basheeraltawil/agrobot-ros2-agricultural-robot-arm/agrobot_ws/src/aibomech_agrobot_description/meshes/link_2.STL

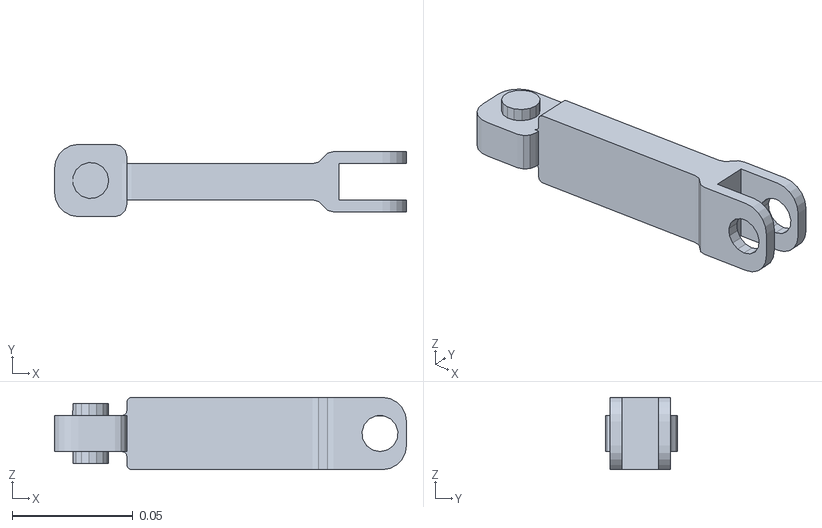
[picture p11: CAD file, 2026-09-24]
agrobot_ws/src/aibomech_agrobot_description/meshes/link_2.STL
0.146 x 0.03 x 0.03
