basheeraltawil/agrobot-ros2-agricultural-robot-arm/agrobot_ws/src/aibomech_agrobot_description/meshes/link_1.STL

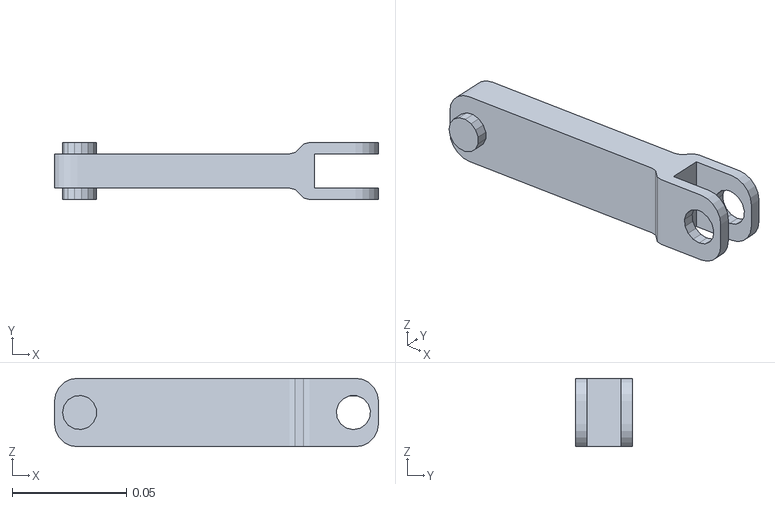
[picture p12: CAD file, 2026-09-24]
agrobot_ws/src/aibomech_agrobot_description/meshes/link_1.STL
0.142 x 0.025 x 0.03
