basheeraltawil/agrobot-ros2-agricultural-robot-arm/agrobot_ws/src/aibomech_agrobot_description/meshes/link_3.STL

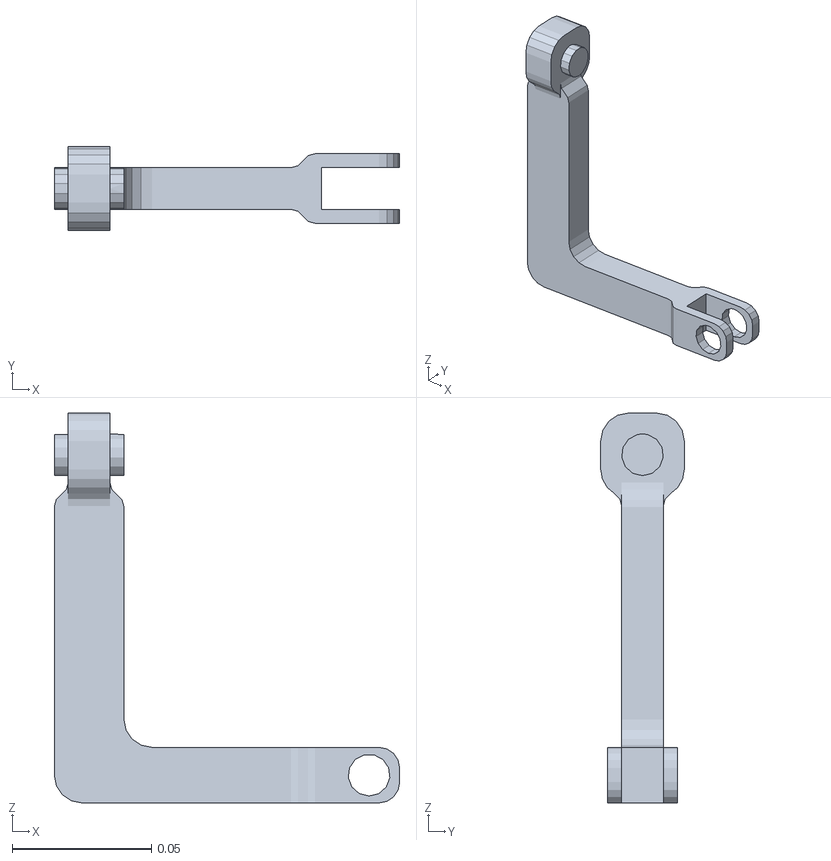
[picture p13: CAD file, 2026-09-24]
agrobot_ws/src/aibomech_agrobot_description/meshes/link_3.STL
0.124 x 0.03 x 0.14
