basheeraltawil/agrobot-ros2-agricultural-robot-arm/agrobot_ws/src/aibomech_agrobot_description/meshes/link_5.STL

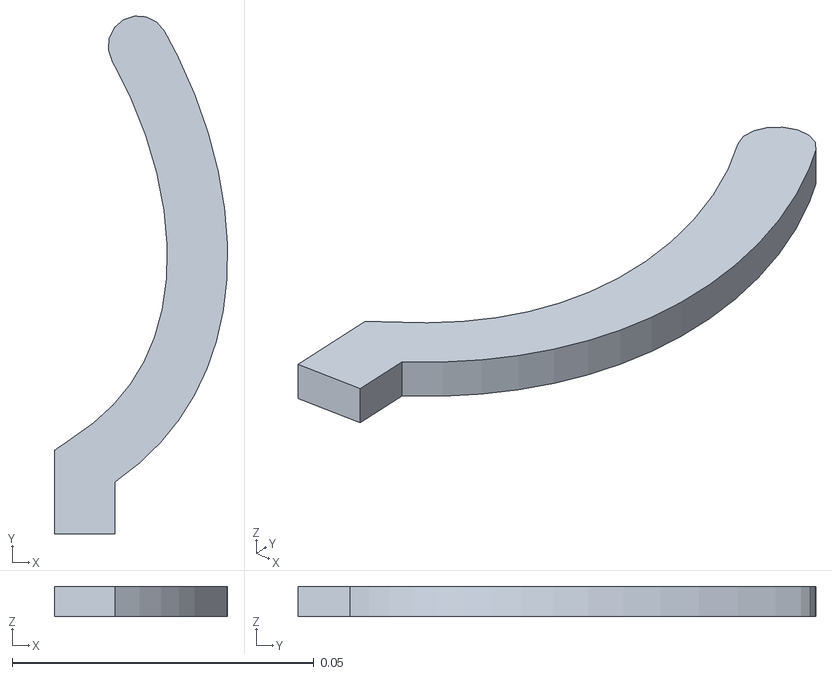
[picture p14: CAD file, 2026-09-24]
agrobot_ws/src/aibomech_agrobot_description/meshes/link_5.STL
0.0287 x 0.0858 x 0.005
