basheeraltawil/agrobot-ros2-agricultural-robot-arm/agrobot_ws/src/aibomech_agrobot_description/meshes/link_4.STL

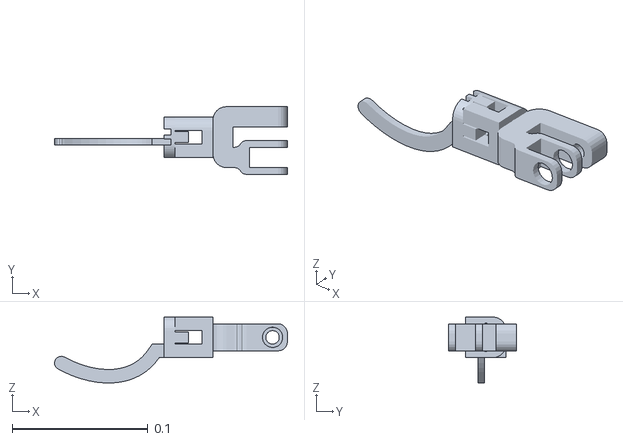
[picture p15: CAD file, 2026-09-24]
agrobot_ws/src/aibomech_agrobot_description/meshes/link_4.STL
0.172 x 0.05 x 0.0487
