basheeraltawil/agrobot-ros2-agricultural-robot-arm/agrobot_ws/src/aibomech_agrobot_description/meshes/base_link.STL

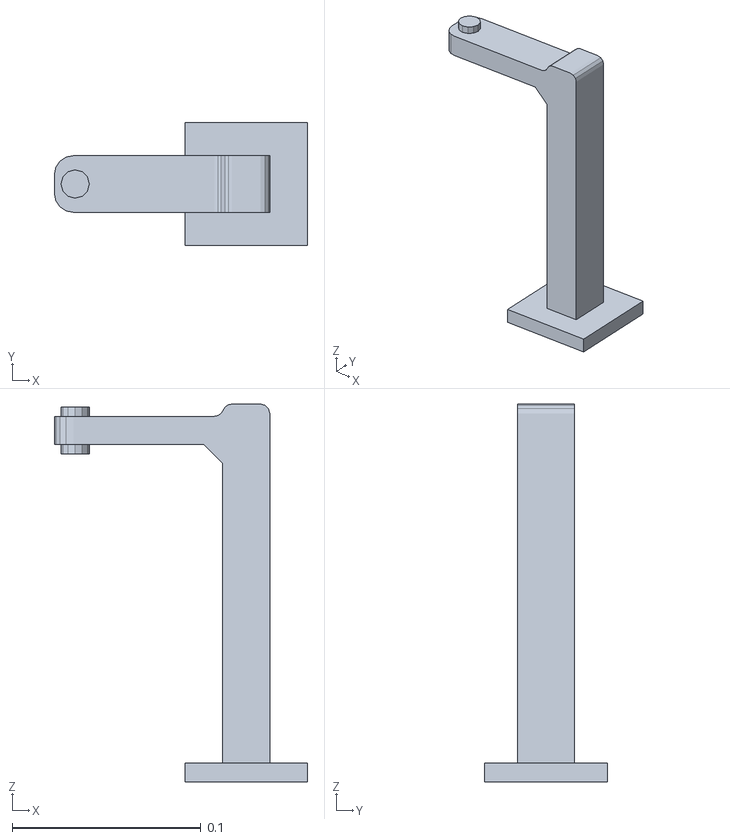
[picture p16: CAD file, 2026-09-24]
agrobot_ws/src/aibomech_agrobot_description/meshes/base_link.STL
0.134 x 0.065 x 0.2
