basheeraltawil/agrobot-ros2-agricultural-robot-arm/analysis/data/agrobot.urdf

<?xml version="1.0" ?>
<!-- =================================================================================== -->
<!-- |    This document was autogenerated by xacro from src/aibomech_agrobot_description/urdf/agrobot.urdf.xacro | -->
<!-- |    EDITING THIS FILE BY HAND IS NOT RECOMMENDED                                 | -->
<!-- =================================================================================== -->
<!--
  AIBOMECH AgroBot - complete robot cell.

  xacro agrobot.urdf.xacro hardware:=gz platform:=rail_trolley mount_height:=0.85
-->
<robot name="agrobot">
  <link name="world"/>
  <!-- Heating-pipe rail, fixed in the greenhouse -->
  <link name="rail">
    <inertial>
      <origin rpy="0 0 0" xyz="1.5 0 0.1"/>
      <mass value="50"/>
      <inertia ixx="0.6770833333333335" ixy="0" ixz="0" iyy="37.510416666666664" iyz="0" izz="38.166666666666664"/>
    </inertial>
    <visual name="pipe_left">
      <origin rpy="0 1.5707963267948966 0" xyz="1.4 0.2 0.1"/>
      <geometry>
        <cylinder length="3.6" radius="0.0255"/>
      </geometry>
      <material name="pipe_white">
        <color rgba="0.92 0.92 0.90 1"/>
      </material>
    </visual>
    <visual name="pipe_right">
      <origin rpy="0 1.5707963267948966 0" xyz="1.4 -0.2 0.1"/>
      <geometry>
        <cylinder length="3.6" radius="0.0255"/>
      </geometry>
      <material name="pipe_white">
        <color rgba="0.92 0.92 0.90 1"/>
      </material>
    </visual>
  </link>
  <joint name="rail_fixed_joint" type="fixed">
    <origin rpy="0 0 0" xyz="0 0 0"/>
    <parent link="world"/>
    <child link="rail"/>
  </joint>
  <link name="trolley">
    <inertial>
      <origin rpy="0 0 0" xyz="0 0 0.1955"/>
      <mass value="25.0"/>
      <inertia ixx="0.48770833333333335" ixy="0" ixz="0" iyy="0.5677083333333334" iyz="0" izz="0.9616666666666668"/>
    </inertial>
    <visual name="deck">
      <origin rpy="0 0 0" xyz="0 0 0.1955"/>
      <geometry>
        <box size="0.5 0.46 0.04"/>
      </geometry>
      <material name="graphite">
        <color rgba="0.20 0.21 0.23 1"/>
      </material>
    </visual>
    <collision name="deck">
      <origin rpy="0 0 0" xyz="0 0 0.1955"/>
      <geometry>
        <box size="0.5 0.46 0.04"/>
      </geometry>
    </collision>
    <visual name="cabinet">
      <origin rpy="0 0 0" xyz="-0.12 -0.10 0.3355"/>
      <geometry>
        <box size="0.22 0.18 0.24"/>
      </geometry>
      <material name="cabinet_grey">
        <color rgba="0.60 0.62 0.64 1"/>
      </material>
    </visual>
    <collision name="cabinet">
      <origin rpy="0 0 0" xyz="-0.12 -0.10 0.3355"/>
      <geometry>
        <box size="0.22 0.18 0.24"/>
      </geometry>
    </collision>
    <!-- Emergency stop button on the cabinet -->
    <visual name="estop_base">
      <origin rpy="0 0 0" xyz="-0.12 -0.10 0.47050000000000003"/>
      <geometry>
        <box size="0.07 0.07 0.03"/>
      </geometry>
      <material name="safety_yellow">
        <color rgba="1.00 0.80 0.00 1"/>
      </material>
    </visual>
    <visual name="estop_button">
      <origin rpy="0 0 0" xyz="-0.12 -0.10 0.49550000000000005"/>
      <geometry>
        <cylinder length="0.02" radius="0.02"/>
      </geometry>
      <material name="estop_red">
        <color rgba="0.85 0.05 0.05 1"/>
      </material>
    </visual>
    <!-- Signal tower -->
    <visual name="signal_tower">
      <origin rpy="0 0 0" xyz="-0.04 -0.16 0.5155"/>
      <geometry>
        <cylinder length="0.12" radius="0.012"/>
      </geometry>
      <material name="signal_green">
        <color rgba="0.10 0.85 0.20 1"/>
      </material>
    </visual>
    <visual>
      <origin rpy="1.5707963267948966 0 0" xyz="0.18 0.2 0.1455"/>
      <geometry>
        <cylinder length="0.03" radius="0.045"/>
      </geometry>
      <material name="black">
        <color rgba="0.06 0.06 0.06 1"/>
      </material>
    </visual>
    <visual>
      <origin rpy="1.5707963267948966 0 0" xyz="-0.18 0.2 0.1455"/>
      <geometry>
        <cylinder length="0.03" radius="0.045"/>
      </geometry>
      <material name="black">
        <color rgba="0.06 0.06 0.06 1"/>
      </material>
    </visual>
    <visual>
      <origin rpy="1.5707963267948966 0 0" xyz="0.18 -0.2 0.1455"/>
      <geometry>
        <cylinder length="0.03" radius="0.045"/>
      </geometry>
      <material name="black">
        <color rgba="0.06 0.06 0.06 1"/>
      </material>
    </visual>
    <visual>
      <origin rpy="1.5707963267948966 0 0" xyz="-0.18 -0.2 0.1455"/>
      <geometry>
        <cylinder length="0.03" radius="0.045"/>
      </geometry>
      <material name="black">
        <color rgba="0.06 0.06 0.06 1"/>
      </material>
    </visual>
  </link>
  <joint name="rail_joint" type="prismatic">
    <origin rpy="0 0 0" xyz="0 0 0"/>
    <parent link="rail"/>
    <child link="trolley"/>
    <axis xyz="1 0 0"/>
    <limit effort="200.0" lower="0.0" upper="3.0" velocity="0.3"/>
    <dynamics damping="20.0" friction="2.0"/>
    <safety_controller k_position="20" k_velocity="666.6666666666667" soft_lower_limit="0.01" soft_upper_limit="2.99"/>
  </joint>
  <link name="lift_column">
    <inertial>
      <origin rpy="0 0 0" xyz="0 0 0.31224999999999997"/>
      <mass value="6.0"/>
      <inertia ixx="0.19820012499999998" ixy="0" ixz="0" iyy="0.19820012499999998" iyz="0" izz="0.0064"/>
    </inertial>
    <visual name="column">
      <origin rpy="0 0 0" xyz="0 0 0.31224999999999997"/>
      <geometry>
        <box size="0.08 0.08 0.6244999999999999"/>
      </geometry>
      <material name="aluminium">
        <color rgba="0.76 0.77 0.79 1"/>
      </material>
    </visual>
    <collision name="column">
      <origin rpy="0 0 0" xyz="0 0 0.31224999999999997"/>
      <geometry>
        <box size="0.08 0.08 0.6244999999999999"/>
      </geometry>
    </collision>
    <visual name="top_plate">
      <origin rpy="0 0 0" xyz="0 0 0.6295"/>
      <geometry>
        <box size="0.12 0.12 0.01"/>
      </geometry>
      <material name="graphite">
        <color rgba="0.20 0.21 0.23 1"/>
      </material>
    </visual>
    <collision name="top_plate">
      <origin rpy="0 0 0" xyz="0 0 0.6295"/>
      <geometry>
        <box size="0.12 0.12 0.01"/>
      </geometry>
    </collision>
    <visual name="crate_bracket">
      <origin rpy="0 0 0" xyz="0.10 -0.04 0.5884999999999999"/>
      <geometry>
        <box size="0.12 0.03 0.008"/>
      </geometry>
      <material name="aluminium">
        <color rgba="0.76 0.77 0.79 1"/>
      </material>
    </visual>
    <collision name="crate_bracket">
      <origin rpy="0 0 0" xyz="0.10 -0.04 0.5884999999999999"/>
      <geometry>
        <box size="0.12 0.03 0.008"/>
      </geometry>
    </collision>
    <visual name="shelf">
      <origin rpy="0 0 0" xyz="0.26 -0.04 0.5884999999999999"/>
      <geometry>
        <box size="0.20 0.14 0.008"/>
      </geometry>
      <material name="aluminium">
        <color rgba="0.76 0.77 0.79 1"/>
      </material>
    </visual>
    <collision name="shelf">
      <origin rpy="0 0 0" xyz="0.26 -0.04 0.5884999999999999"/>
      <geometry>
        <box size="0.20 0.14 0.008"/>
      </geometry>
    </collision>
    <visual name="crate_floor">
      <origin rpy="0 0 0" xyz="0.26 -0.04 0.5944999999999999"/>
      <geometry>
        <box size="0.16 0.12 0.004"/>
      </geometry>
      <material name="crate_green">
        <color rgba="0.10 0.45 0.20 1"/>
      </material>
    </visual>
    <collision name="crate_floor">
      <origin rpy="0 0 0" xyz="0.26 -0.04 0.5944999999999999"/>
      <geometry>
        <box size="0.16 0.12 0.004"/>
      </geometry>
    </collision>
    <visual name="crate_wall_n">
      <origin rpy="0 0 0" xyz="0.26 0.018000000000000002 0.6189999999999999"/>
      <geometry>
        <box size="0.16 0.004 0.045"/>
      </geometry>
      <material name="crate_green">
        <color rgba="0.10 0.45 0.20 1"/>
      </material>
    </visual>
    <collision name="crate_wall_n">
      <origin rpy="0 0 0" xyz="0.26 0.018000000000000002 0.6189999999999999"/>
      <geometry>
        <box size="0.16 0.004 0.045"/>
      </geometry>
    </collision>
    <visual name="crate_wall_s">
      <origin rpy="0 0 0" xyz="0.26 -0.098 0.6189999999999999"/>
      <geometry>
        <box size="0.16 0.004 0.045"/>
      </geometry>
      <material name="crate_green">
        <color rgba="0.10 0.45 0.20 1"/>
      </material>
    </visual>
    <collision name="crate_wall_s">
      <origin rpy="0 0 0" xyz="0.26 -0.098 0.6189999999999999"/>
      <geometry>
        <box size="0.16 0.004 0.045"/>
      </geometry>
    </collision>
    <visual name="crate_wall_e">
      <origin rpy="0 0 0" xyz="0.338 -0.04 0.6189999999999999"/>
      <geometry>
        <box size="0.004 0.12 0.045"/>
      </geometry>
      <material name="crate_green">
        <color rgba="0.10 0.45 0.20 1"/>
      </material>
    </visual>
    <collision name="crate_wall_e">
      <origin rpy="0 0 0" xyz="0.338 -0.04 0.6189999999999999"/>
      <geometry>
        <box size="0.004 0.12 0.045"/>
      </geometry>
    </collision>
    <visual name="crate_wall_w">
      <origin rpy="0 0 0" xyz="0.182 -0.04 0.6189999999999999"/>
      <geometry>
        <box size="0.004 0.12 0.045"/>
      </geometry>
      <material name="crate_green">
        <color rgba="0.10 0.45 0.20 1"/>
      </material>
    </visual>
    <collision name="crate_wall_w">
      <origin rpy="0 0 0" xyz="0.182 -0.04 0.6189999999999999"/>
      <geometry>
        <box size="0.004 0.12 0.045"/>
      </geometry>
    </collision>
  </link>
  <joint name="lift_column_joint" type="fixed">
    <origin rpy="0 0 0" xyz="0 0 0.2155"/>
    <parent link="trolley"/>
    <child link="lift_column"/>
  </joint>
  <link name="arm_mount"/>
  <joint name="arm_mount_plate_joint" type="fixed">
    <origin rpy="0 0 0" xyz="0 0 0.6345"/>
    <parent link="lift_column"/>
    <child link="arm_mount"/>
  </joint>
  <link name="crate"/>
  <joint name="crate_joint" type="fixed">
    <origin rpy="0 0 0" xyz="0.26 -0.04 0.5964999999999999"/>
    <parent link="lift_column"/>
    <child link="crate"/>
  </joint>
  <joint name="arm_mount_joint" type="fixed">
    <origin rpy="0 0 -1.5707963267948966" xyz="5.541526766141773e-18 -0.0905 0"/>
    <parent link="arm_mount"/>
    <child link="base_link"/>
  </joint>
  <link name="base_link">
    <inertial>
      <origin rpy="0 0 0" xyz="-0.026053 0.081809 0.033589"/>
      <mass value="0.30992"/>
      <inertia ixx="0.0032328" ixy="-0.00016898" ixz="0.00067089" iyy="0.0019913" iyz="0.00085164" izz="0.002236"/>
    </inertial>
    <visual>
      <origin rpy="0 0 0" xyz="0 0 0"/>
      <geometry>
        <mesh filename="package://aibomech_agrobot_description/meshes/base_link.STL"/>
      </geometry>
      <material name="graphite">
        <color rgba="0.20 0.21 0.23 1"/>
      </material>
    </visual>
    <collision>
      <origin rpy="0 0 0" xyz="0.0 0.0 0.005"/>
      <geometry>
        <box size="0.065 0.065 0.01"/>
      </geometry>
    </collision>
    <collision>
      <origin rpy="0 0 0" xyz="-0.0012 0.0 0.105"/>
      <geometry>
        <box size="0.0274 0.03 0.19"/>
      </geometry>
    </collision>
    <collision>
      <origin rpy="0 0 0" xyz="-0.0445 0.0 0.1868"/>
      <geometry>
        <box size="0.114 0.03 0.0265"/>
      </geometry>
    </collision>
  </link>
  <link name="link_1">
    <inertial>
      <origin rpy="0 0 0" xyz="-0.091521 0.00658 0.0"/>
      <mass value="0.126691"/>
      <inertia ixx="2.1228e-05" ixy="-2.1359e-05" ixz="4.3792e-20" iyy="0.00020892" iyz="-3.2393e-21" izz="0.00021411"/>
    </inertial>
    <visual>
      <origin rpy="0 0 0" xyz="0 0 0"/>
      <geometry>
        <mesh filename="package://aibomech_agrobot_description/meshes/link_1.STL"/>
      </geometry>
      <material name="agro_orange">
        <color rgba="0.93 0.45 0.07 1"/>
      </material>
    </visual>
    <collision>
      <origin rpy="0 0 0" xyz="-0.06 0.0125 0.0"/>
      <geometry>
        <box size="0.142 0.025 0.03"/>
      </geometry>
    </collision>
  </link>
  <link name="link_2">
    <inertial>
      <origin rpy="0 0 0" xyz="-0.092119 0.012812 -0.0"/>
      <mass value="0.128494"/>
      <inertia ixx="1.6446e-05" ixy="1.1133e-06" ixz="1.7062e-20" iyy="0.0002116" iyz="-2.3356e-22" izz="0.00021285"/>
    </inertial>
    <visual>
      <origin rpy="0 0 0" xyz="0 0 0"/>
      <geometry>
        <mesh filename="package://aibomech_agrobot_description/meshes/link_2.STL"/>
      </geometry>
      <material name="agro_orange">
        <color rgba="0.93 0.45 0.07 1"/>
      </material>
    </visual>
    <collision>
      <origin rpy="0 0 0" xyz="-0.062 0.013 0.0"/>
      <geometry>
        <box size="0.146 0.03 0.03"/>
      </geometry>
    </collision>
  </link>
  <link name="link_3">
    <inertial>
      <origin rpy="0 0 0" xyz="-0.066151 -0.0 0.071691"/>
      <mass value="0.149855"/>
      <inertia ixx="0.00038087" ixy="-2.0456e-20" ixz="-3.5869e-05" iyy="0.00052704" iyz="-3.8463e-19" izz="0.00015793"/>
    </inertial>
    <visual>
      <origin rpy="0 0 0" xyz="0 0 0"/>
      <geometry>
        <mesh filename="package://aibomech_agrobot_description/meshes/link_3.STL"/>
      </geometry>
      <material name="agro_orange">
        <color rgba="0.93 0.45 0.07 1"/>
      </material>
    </visual>
    <collision>
      <origin rpy="0 0 0" xyz="-0.051 0.0 0.06"/>
      <geometry>
        <box size="0.124 0.03 0.14"/>
      </geometry>
    </collision>
  </link>
  <link name="link_4">
    <inertial>
      <origin rpy="0 0 0" xyz="-0.051725 0.075198 -0.0014"/>
      <mass value="0.083591"/>
      <inertia ixx="1.4679e-05" ixy="1.9855e-06" ixz="4.0528e-07" iyy="3.1218e-05" iyz="-1.8316e-07" izz="3.7434e-05"/>
    </inertial>
    <visual>
      <origin rpy="0 0 0" xyz="0 0 0"/>
      <geometry>
        <mesh filename="package://aibomech_agrobot_description/meshes/link_4.STL"/>
      </geometry>
      <material name="graphite">
        <color rgba="0.20 0.21 0.23 1"/>
      </material>
    </visual>
    <collision>
      <origin rpy="0 0 0" xyz="-0.0345 0.0712 0.0"/>
      <geometry>
        <box size="0.091 0.05 0.03"/>
      </geometry>
    </collision>
    <collision>
      <origin rpy="0 0 0" xyz="-0.1316 0.0702 -0.0238"/>
      <geometry>
        <box size="0.0585 0.005 0.0197"/>
      </geometry>
    </collision>
  </link>
  <link name="link_5">
    <inertial>
      <origin rpy="0 0 0" xyz="0.016259 0.041204 0.0025"/>
      <mass value="0.005123"/>
      <inertia ixx="3.115e-06" ixy="-4.3385e-07" ixz="3.7949e-12" iyy="2.6365e-07" iyz="5.7193e-12" izz="3.3573e-06"/>
    </inertial>
    <visual>
      <origin rpy="0 0 0" xyz="0 0 0"/>
      <geometry>
        <mesh filename="package://aibomech_agrobot_description/meshes/link_5.STL"/>
      </geometry>
      <material name="aluminium">
        <color rgba="0.76 0.77 0.79 1"/>
      </material>
    </visual>
    <collision>
      <origin rpy="0 0 0" xyz="0.0137 0.0429 0.0025"/>
      <geometry>
        <box size="0.0287 0.0858 0.005"/>
      </geometry>
    </collision>
  </link>
  <joint name="joint_1" type="revolute">
    <origin rpy="1.5708 0 -0.65897" xyz="-0.0905 0 0.1735"/>
    <parent link="base_link"/>
    <child link="link_1"/>
    <axis xyz="0 1 0"/>
    <limit effort="2.9" lower="-1.09" upper="2.1" velocity="2.0"/>
    <dynamics damping="0.1" friction="0.05"/>
    <safety_controller k_position="20" k_velocity="1.45" soft_lower_limit="-1.06" soft_upper_limit="2.0700000000000003"/>
  </joint>
  <joint name="joint_2" type="revolute">
    <origin rpy="0 0.60223 0" xyz="-0.12 0 0"/>
    <parent link="link_1"/>
    <child link="link_2"/>
    <axis xyz="0 1 0"/>
    <limit effort="2.9" lower="-2.1" upper="1.11" velocity="2.0"/>
    <dynamics damping="0.1" friction="0.05"/>
    <safety_controller k_position="20" k_velocity="1.45" soft_lower_limit="-2.0700000000000003" soft_upper_limit="1.08"/>
  </joint>
  <joint name="joint_3" type="revolute">
    <origin rpy="1.5708 0 0.49429" xyz="-0.12 0.013028 0"/>
    <parent link="link_2"/>
    <child link="link_3"/>
    <axis xyz="0 1 0"/>
    <limit effort="2.9" lower="-2.0" upper="1.1" velocity="2.0"/>
    <dynamics damping="0.1" friction="0.05"/>
    <safety_controller k_position="20" k_velocity="1.45" soft_lower_limit="-1.97" soft_upper_limit="1.07"/>
  </joint>
  <joint name="joint_4" type="revolute">
    <origin rpy="0 0.88733 1.5708" xyz="-0.041826 0 0.115"/>
    <parent link="link_3"/>
    <child link="link_4"/>
    <axis xyz="0 1 0"/>
    <limit effort="1.5" lower="-1.0" upper="2.3" velocity="3.0"/>
    <dynamics damping="0.05" friction="0.02"/>
    <safety_controller k_position="20" k_velocity="0.5" soft_lower_limit="-0.97" soft_upper_limit="2.27"/>
  </joint>
  <joint name="gripper_jaw_joint" type="prismatic">
    <origin rpy="-0.84443 -1.5708 2.4684" xyz="-0.075 0.080174 0"/>
    <parent link="link_4"/>
    <child link="link_5"/>
    <axis xyz="1 0 0"/>
    <limit effort="20.0" lower="-0.017" upper="0.01" velocity="0.05"/>
    <dynamics damping="0.5" friction="0.1"/>
    <safety_controller k_position="20" k_velocity="400.0" soft_lower_limit="-0.0165" soft_upper_limit="0.0095"/>
  </joint>
  <!-- Standard frames -->
  <link name="base"/>
  <joint name="base_link-base" type="fixed">
    <origin rpy="0 0 3.141592653589793" xyz="-0.0905 0 0"/>
    <parent link="base_link"/>
    <child link="base"/>
  </joint>
  <link name="flange"/>
  <joint name="link_4-flange" type="fixed">
    <origin rpy="0 -1.5707963267948966 0" xyz="-0.075 0.0725 0"/>
    <parent link="link_4"/>
    <child link="flange"/>
  </joint>
  <link name="tool0"/>
  <joint name="flange-tool0" type="fixed">
    <origin rpy="0 0 0" xyz="0 0 0"/>
    <parent link="flange"/>
    <child link="tool0"/>
  </joint>
  <!-- tcp: x = jaw closing direction, z = approach direction -->
  <link name="tcp"/>
  <joint name="link_4-tcp" type="fixed">
    <origin rpy="0 -1.5707963267948966 0" xyz="-0.135 0.0725 -0.008"/>
    <parent link="link_4"/>
    <child link="tcp"/>
  </joint>
  <!-- tcp_center: middle of the open jaw gap. Use it for thin objects (stems)
         that must not touch the fixed jaw on the way in. -->
  <link name="tcp_center"/>
  <joint name="link_4-tcp_center" type="fixed">
    <origin rpy="0 -1.5707963267948966 0" xyz="-0.135 0.0725 -0.003"/>
    <parent link="link_4"/>
    <child link="tcp_center"/>
  </joint>
  <link name="camera_mast">
    <visual>
      <origin rpy="0 0 0" xyz="0 0 0.11249999999999999"/>
      <geometry>
        <box size="0.02 0.02 1.015"/>
      </geometry>
      <material name="aluminium">
        <color rgba="0.76 0.77 0.79 1"/>
      </material>
    </visual>
    <collision>
      <origin rpy="0 0 0" xyz="0 0 0.11249999999999999"/>
      <geometry>
        <box size="0.02 0.02 1.015"/>
      </geometry>
    </collision>
    <inertial>
      <origin rpy="0 0 0" xyz="0 0 0.31"/>
      <mass value="0.3"/>
      <inertia ixx="0.009609999999999999" ixy="0" ixz="0" iyy="0.009609999999999999" iyz="0" izz="2e-5"/>
    </inertial>
  </link>
  <joint name="camera_mast_joint" type="fixed">
    <origin rpy="0 0 0" xyz="-0.20 -0.18 0"/>
    <parent link="arm_mount"/>
    <child link="camera_mast"/>
  </joint>
  <link name="camera_link">
    <visual>
      <origin rpy="0 0 0" xyz="-0.0125 0 0"/>
      <geometry>
        <box size="0.025 0.09 0.025"/>
      </geometry>
      <material name="black">
        <color rgba="0.06 0.06 0.06 1"/>
      </material>
    </visual>
    <collision>
      <origin rpy="0 0 0" xyz="-0.0125 0 0"/>
      <geometry>
        <box size="0.025 0.09 0.025"/>
      </geometry>
    </collision>
    <inertial>
      <origin rpy="0 0 0" xyz="-0.0125 0 0"/>
      <mass value="0.072"/>
      <inertia ixx="5.2e-5" ixy="0" ixz="0" iyy="7.5e-6" iyz="0" izz="5.2e-5"/>
    </inertial>
  </link>
  <joint name="camera_joint" type="fixed">
    <origin rpy="0 0.93 1.075" xyz="0 0 0.60"/>
    <parent link="camera_mast"/>
    <child link="camera_link"/>
  </joint>
  <link name="camera_color_optical_frame"/>
  <joint name="camera_optical_joint" type="fixed">
    <origin rpy="-1.5707963267948966 0 -1.5707963267948966" xyz="0 0 0"/>
    <parent link="camera_link"/>
    <child link="camera_color_optical_frame"/>
  </joint>
  <ros2_control name="AgrobotSystem" type="system">
    <hardware>
      <plugin>mock_components/GenericSystem</plugin>
      <param name="calculate_dynamics">true</param>
    </hardware>
    <joint name="joint_1">
      <command_interface name="position">
        <param name="min">-1.09</param>
        <param name="max">2.1</param>
      </command_interface>
      <state_interface name="position">
        <param name="initial_value">-0.97</param>
      </state_interface>
      <state_interface name="velocity"/>
    </joint>
    <joint name="joint_2">
      <command_interface name="position">
        <param name="min">-2.1</param>
        <param name="max">1.11</param>
      </command_interface>
      <state_interface name="position">
        <param name="initial_value">-2.0</param>
      </state_interface>
      <state_interface name="velocity"/>
    </joint>
    <joint name="joint_3">
      <command_interface name="position">
        <param name="min">-2.0</param>
        <param name="max">1.1</param>
      </command_interface>
      <state_interface name="position">
        <param name="initial_value">-1.12</param>
      </state_interface>
      <state_interface name="velocity"/>
    </joint>
    <joint name="joint_4">
      <command_interface name="position">
        <param name="min">-1.0</param>
        <param name="max">2.3</param>
      </command_interface>
      <state_interface name="position">
        <param name="initial_value">1.46</param>
      </state_interface>
      <state_interface name="velocity"/>
    </joint>
    <joint name="gripper_jaw_joint">
      <command_interface name="position">
        <param name="min">-0.017</param>
        <param name="max">0.01</param>
      </command_interface>
      <state_interface name="position">
        <param name="initial_value">0.01</param>
      </state_interface>
      <state_interface name="velocity"/>
    </joint>
    <joint name="rail_joint">
      <command_interface name="position">
        <param name="min">0.0</param>
        <param name="max">3.0</param>
      </command_interface>
      <state_interface name="position">
        <param name="initial_value">0.05</param>
      </state_interface>
      <state_interface name="velocity"/>
    </joint>
  </ros2_control>
</robot>
