basheeraltawil/agrobot-ros2-agricultural-robot-arm/(commit log)

2026-09-24 Import original ROS 1 aibomech_agrobot_v2 description package
    SolidWorks-exported URDF, meshes, catkin launch files and the
    joint_states_to_gazebo bridge script, kept as the starting point for
    the ROS 2 port.
    [aibomech_agrobot_v2.csv, aibomech_agrobot_v2.urdf, aibomech_agrobot_v2_gazebo_command.urdf, aibomech_agrobot_v2_joint_state.urdf, base_link.STL, link_1.STL, link_2.STL, link_3.STL]
2026-09-24 Remove obsolete URDF files and add new mass properties CSV and mesh files for aibomech_agrobot_v2
    - Deleted the old URDF files: aibomech_agrobot_v2_gazebo_command.urdf and aibomech_agrobot_v2_joint_state.urdf.
    - Introduced a new CSV file for mass properties: aibomech_agrobot_v2_mass_properties.csv.
    - Added new mesh files for the robot links: base_link.STL, link_1.STL, link_2.STL, link_3.STL, link_4.STL, and link_5.STL.
    [aibomech_agrobot_v2.urdf, aibomech_agrobot_v2_gazebo_command.urdf, aibomech_agrobot_v2_joint_state.urdf, aibomech_agrobot_v2_mass_properties.csv, base_link.STL, link_1.STL, link_2.STL, link_3.STL]
2026-09-24 Complete ROS 2 AgroBot: collision-aware tasks, four scenarios, README
    - Task layer: box collision model built from the URDF, joint-space
    RRT-Connect planner, collision-checked IK and linear moves, rail used as
    an external axis with reachability checks, crops and fixtures as obstacles
    - New scenarios: seedling transplanting, precision weeding and plant
    inspection, alongside strawberry harvesting; per-run KPI reports
    - Robot model: split base/gripper collision boxes, raised crate beside the
    arm, camera mast moved out of the arm's reach, inline material colours,
    collision-free home pose, rail starting off its end stop
    - Worlds: static crop fixtures (joints to world froze the rail in F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
    [agrobot.urdf, agrobot.urdf.xacro, arm.xacro, camera.xacro, materials.xacro, nursery_transplanting.sdf, platform.xacro, weeding_bed.sdf]
2026-09-24 Put the packages in a ready-to-build colcon workspace, agrobot_ws/
    Clone, cd agrobot_ws, colcon build. README paths and install steps updated.
    [agrobot.gazebo.xacro, agrobot.ros2_control.xacro, agrobot.urdf, agrobot.urdf.xacro, aibomech_agrobot_v2_mass_properties.csv, arm.xacro, base_link.STL, camera.xacro]
2026-09-24 README: link fuzzy-logic video walkthrough; ROS 2 updates
    [nursery_transplanting.sdf]
2026-09-24 Enhance collision detection and handling for precision weeding and seedling transplant tasks
    - Updated the CollisionModel to include an obstacle clearance parameter, ensuring that obstacles remain a safe distance away from the robot's held objects.
    - Modified the RobotInterface to incorporate held object dimensions and offsets for improved collision checking during movement.
    - Refactored the PrecisionWeeding task to include a retry mechanism for weed removal attempts, logging outcomes and distances to nearby crops.
    - Added configuration parameters for held object sizes and offsets in both precision weeding and seedling transplant YAML files, allowing for better collision detection with the r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
    [agrobot.urdf, arm.xacro, weeding_bed.sdf]
2026-09-24 Reliable grasping in all scenarios, README with Mermaid architecture docs
    Fixes for crops that were sometimes not grasped:
    - Straight-line moves interpolate between the planned start and end
    configurations, so the wrist no longer flips half-way (fallback: step-wise
    tracking); planning checks the approach and retreat lines that way
    - Harvest tries tilted approach directions and more rail positions, retries
    blocked fruit in a second pass, checks the retreat with the fruit held and
    keeps the fruit if the straight retreat is blocked
    - Transplant and weeding: fold the arm before rail travel, seedlings and
    lettuce as obstacles, held-crop geometry per task, second pass
    - Compliant approac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
    [seedling_transplant.yaml, strawberry_harvest.yaml]
2026-09-25 Analysis folder: thesis derivation, Python recomputation, workspace and torque sizing
    - analysis/mathematica: the thesis notebooks, renamed in derivation order,
    with plain-text exports and an index with the review findings
    - analysis/python: robot_model.py (FK, Jacobians, M, C, G from the URDF,
    self-checked), symbolic thesis kinematics, workspace and approach maps,
    check of the thesis torques, actuator sizing, design calculations
    - analysis/README.md: formulas, results and figures
    - analysis/tools/nb_to_text.py: read Mathematica notebooks without Mathematica
    [agrobot.urdf]
2026-09-25 Documentation restructure, package READMEs, code headers and CI
    - README rewritten as a short front page; details split into docs/
    (scenarios, robot design, architecture, real robot, development,
    glossary, ROS 1 to ROS 2)
    - Scenarios document the real-world problem and the path to the field
    - README per package with files, launch commands and a code reading order
    - File headers for the hardware driver sources and module maps in the
    task package
    - GitHub Actions workflow: build and test in ros:humble
    - CITATION.cff
    [hardware_calibration.yaml]
2026-09-25 Analysis: D-H kinematics and Lagrangian dynamics explained from the paper
    - analysis/kinematics.md: D-H convention and table, all transformation
    matrices, forward kinematics of both end effectors, Jacobian, closed-form
    inverse kinematics, each with a worked example
    - analysis/dynamics.md: Lagrange equation, inertia matrix, Christoffel
    symbols, Coriolis and gravity terms, evaluated example, servo sizing
    - 01_kinematics_thesis_model.py: D-H product checked against the paper,
    worked example, wrist IK; finds a sign error in notebook R40
    - 03_thesis_dynamics_check.py: M, C, G and torques of the example
    - 04_torque_sizing.py: comparison with the prototype's LX-16A servos
    - Paper text in an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
2026-09-25 Repository renamed; harvesting GIF; drop the ROS 1 page
    - Links, badge, clone commands and CITATION.cff point to
    agrobot-ros2-agricultural-robot-arm
    - Strawberry-harvesting GIF (Gazebo, 8x) in the README and scenarios
    - Removed docs/ros1_to_ros2.md and ROS 1 mentions
2026-09-25 README: add the 3D-rendered CAD design next to the prototype and simulation
2026-09-25 Revise homogeneous transformation notation in kinematics
    Updated mathematical representation of the homogeneous transformation for clarity and consistency.
2026-09-25 Fix math formatting in kinematics.md
    Updated mathematical notation for homogeneous transformation in kinematics.
2026-09-25 Replace operatorname with mathrm in kinematics.md
