basheeraltawil/agrobot-ros2-agricultural-robot-arm/(notices)

Notices in the files:
README.md:
License: BSD-3-Clause
